Rudran97/pearl/pearl_files_git/Pearl/images/loading_screen.png

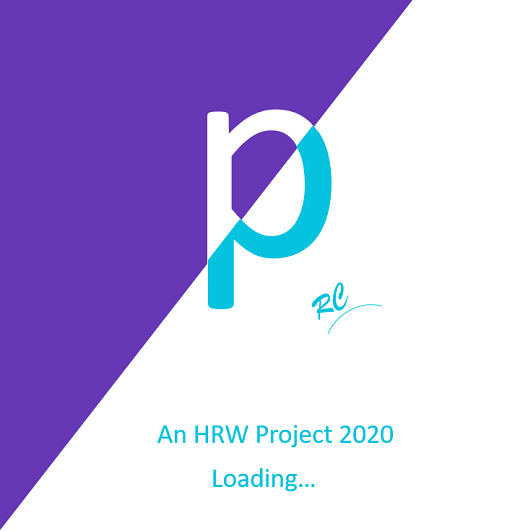
pearl_files_git/Pearl/images/loading_screen.png
