Rudran97/pearl/pearl_files_git/VHDL/rtl/control_fsm.vhd

----------------------------------------------------------------------------------
-- Company: 
-- Engineer: 
-- 
-- Create Date:    14:27:21 04/07/2020 
-- Design Name: 
-- Module Name:    CU2_e - CU2_a 
-- Project Name: 
-- Target Devices: 
-- Tool versions: 
-- Description: 
--
-- Dependencies: 
--
-- Revision: 
-- Revision 0.01 - File Created
-- Additional Comments: 
--
----------------------------------------------------------------------------------
library IEEE;
use IEEE.STD_LOGIC_1164.ALL;
use work.control_fsm_p.all;

-- Uncomment the following library declaration if using
-- arithmetic functions with Signed or Unsigned values
--use IEEE.NUMERIC_STD.ALL;

-- Uncomment the following library declaration if instantiating
-- any Xilinx primitives in this code.
--library UNISIM;
--use UNISIM.VComponents.all;

entity control_fsm is
	generic(
		gi_max_control_signal : integer := 74
	);
	port(pil_reset          : in  std_logic;
	     pil_clk            : in  std_logic;
	     pil_run_prog       : in  std_logic;
	     pil_halt_CU        : in  std_logic;
	     pov_CU_IR          : in  std_logic_vector(7 downto 0);
	     pil_CF_flag        : in  std_logic;
	     pil_ZF_flag        : in  std_logic;
	     pil_TF0_flag       : in  std_logic;
	     pil_TOV_flag       : in  std_logic;
	     pov_en_control_sig : out std_logic_vector(gi_max_control_signal downto 0)
	     );
end control_fsm;


architecture rtl of control_fsm is
	
	signal st_pr_step : CU_step_t := CU_fetch0a_st;

begin
	
	process (pil_reset, pil_clk)
	begin
		if (pil_reset = '1') then
			st_pr_step <= CU_fetch0a_st;
			pov_en_control_sig <= (others => '0');
		elsif (pil_clk'event and pil_clk = '0') then
			if (pil_run_prog = '1') then
				if (pil_halt_CU = '0') then
					case st_pr_step is
						when CU_fetch0a_st =>
							pov_en_control_sig (41 downto 0) <= c_fetch (0);
							pov_en_control_sig (ci_max_control_L downto 43) <= (others => '0');
							pov_en_control_sig (gi_max_control_signal downto 72) <= (others => '0');
							st_pr_step <= CU_fetch0b_st;
						
						when CU_fetch0b_st =>
							st_pr_step <= CU_fetch1a_st;
						
						when CU_fetch1a_st =>
							pov_en_control_sig (41 downto 0) <= c_fetch (1);
							pov_en_control_sig (ci_max_control_L downto 43) <= (others => '0');
							st_pr_step <= CU_fetch1b_st;
							
						when CU_fetch1b_st =>
							st_pr_step <= CU_fetch2_st;
							
						when CU_fetch2_st =>
							pov_en_control_sig (41 downto 0) <= c_fetch (2);
							pov_en_control_sig (ci_max_control_L downto 43) <= (others => '0');
							st_pr_step <= CU_0a_st;
							
						when CU_0a_st =>
							if (pov_CU_IR = cv_IC_NOP) then
								pov_en_control_sig (41 downto 0) <= (others => '0');
								pov_en_control_sig (ci_max_control_L downto 43) <= (others => '0');
								st_pr_step <= CU_0b_st;
							elsif (pov_CU_IR = cv_IC_LDA) then
								pov_en_control_sig (41 downto 0) <= c_LDA (0);
								pov_en_control_sig (ci_max_control_L downto 43) <= (others => '0');
								st_pr_step <= CU_0b_st;
							elsif (pov_CU_IR = cv_IC_ADD) then
								pov_en_control_sig (41 downto 0) <= c_ADD (0);
								pov_en_control_sig (ci_max_control_L downto 43) <= (others => '0');
								st_pr_step <= CU_0b_st;
							elsif (pov_CU_IR = cv_IC_SUB) then
								pov_en_control_sig (41 downto 0) <= c_SUB (0);
								pov_en_control_sig (ci_max_control_L downto 43) <= (others => '0');
								st_pr_step <= CU_0b_st;
							elsif (pov_CU_IR = cv_IC_STA) then
								pov_en_control_sig (41 downto 0) <= c_STA (0);
								pov_en_control_sig (ci_max_control_L downto 43) <= (others => '0');
								st_pr_step <= CU_0b_st;
							elsif (pov_CU_IR = cv_IC_LDI) then
								pov_en_control_sig (41 downto 0) <= c_LDI (0);
								pov_en_control_sig (ci_max_control_L downto 43) <= (others => '0');
								st_pr_step <= CU_0b_st;
							elsif (pov_CU_IR = cv_IC_JMP) then
								pov_en_control_sig (41 downto 0) <= c_JMP (0);
								pov_en_control_sig (ci_max_control_L downto 43) <= (others => '0');
								st_pr_step <= CU_0b_st;
							elsif (pov_CU_IR = cv_IC_JMC) then    --Instruction for JMP when Carry 
								if (pil_CF_flag = '1') then
									pov_en_control_sig (41 downto 0) <= c_JMP (0);			--JMP when carry set
									pov_en_control_sig (ci_max_control_L downto 43) <= (others => '0');
									st_pr_step <= CU_0b_st;
								else
									pov_en_control_sig (41 downto 0) <= c_JMP (1);			--No action when carry cleared
									pov_en_control_sig (ci_max_control_L downto 43) <= (others => '0');
									st_pr_step <= CU_0b_st;
								end if;
							elsif (pov_CU_IR = cv_IC_JMZ) then    --Instruction for JMP when Zero
								if (pil_ZF_flag = '1') then
									pov_en_control_sig (41 downto 0) <= c_JMP (0);			--JMP when Zero set
									pov_en_control_sig (ci_max_control_L downto 43) <= (others => '0');
									st_pr_step <= CU_0b_st;
								else
									pov_en_control_sig (41 downto 0) <= c_JMP (1);			--No action when Zero cleared
									pov_en_control_sig (ci_max_control_L downto 43) <= (others => '0');
									st_pr_step <= CU_0b_st;
								end if;
							elsif (pov_CU_IR = cv_IC_MOV_R0A) then
								pov_en_control_sig (41 downto 0) <= c_MOV_R0A (0);
								pov_en_control_sig (ci_max_control_L downto 43) <= (others => '0');
								st_pr_step <= CU_0b_st;
							elsif (pov_CU_IR = cv_IC_MOV_R0B) then
								pov_en_control_sig (41 downto 0) <= c_MOV_R0B (0);
								pov_en_control_sig (ci_max_control_L downto 43) <= (others => '0');
								st_pr_step <= CU_0b_st;
							elsif (pov_CU_IR = cv_IC_MOV_R0) then
								pov_en_control_sig (41 downto 0) <= c_MOV_R0 (0);
								pov_en_control_sig (ci_max_control_L downto 43) <= (others => '0');
								st_pr_step <= CU_0b_st;
							elsif (pov_CU_IR = cv_IC_MOV_A_R0A) then
								pov_en_control_sig (41 downto 0) <= c_MOV_A_R0A (0);
								pov_en_control_sig (ci_max_control_L downto 43) <= (others => '0');
								st_pr_step <= CU_0b_st;
							elsif (pov_CU_IR = cv_IC_MOV_A_R0B) then
								pov_en_control_sig (41 downto 0) <= c_MOV_A_R0B (0);
								pov_en_control_sig (ci_max_control_L downto 43) <= (others => '0');
								st_pr_step <= CU_0b_st;
							elsif (pov_CU_IR = cv_IC_OUT) then
								pov_en_control_sig (41 downto 0) <= c_OUT (0);
								pov_en_control_sig (ci_max_control_L downto 43) <= (others => '0');
								st_pr_step <= CU_0b_st;
							elsif (pov_CU_IR = cv_IC_HLT) then
								pov_en_control_sig (41 downto 0) <= c_HLT (0);
								pov_en_control_sig (ci_max_control_L downto 43) <= (others => '0');
								st_pr_step <= CU_0b_st;
							elsif (pov_CU_IR = cv_IC_MOV_A_R0) then
								pov_en_control_sig (41 downto 0) <= c_MOV_A_R0 (0);
								pov_en_control_sig (ci_max_control_L downto 43) <= (others => '0');
								st_pr_step <= CU_0b_st;
							elsif (pov_CU_IR = cv_IC_MOV_R0_A) then
								pov_en_control_sig (41 downto 0) <= c_MOV_R0_A (0);
								pov_en_control_sig (ci_max_control_L downto 43) <= (others => '0');
								st_pr_step <= CU_0b_st;
							elsif (pov_CU_IR = cv_IC_MOV_R1A) then
								pov_en_control_sig (41 downto 0) <= c_MOV_R1A (0);
								pov_en_control_sig (ci_max_control_L downto 43) <= (others => '0');
								st_pr_step <= CU_0b_st;
							elsif (pov_CU_IR = cv_IC_MOV_R1B) then
								pov_en_control_sig (41 downto 0) <= c_MOV_R1B (0);
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
								pov_en_control_sig (41 downto 0) <= c_MOV_P0_A (0);
								pov_en_control_sig (ci_max_control_L downto 43) <= (others => '0');
								st_pr_step <= CU_0b_st;
							elsif (pov_CU_IR = cv_IC_MOV_P0) then
								pov_en_control_sig (41 downto 0) <= c_MOV_P0 (0);
								pov_en_control_sig (ci_max_control_L downto 43) <= (others => '0');
								st_pr_step <= CU_0b_st;
							elsif (pov_CU_IR = cv_IC_JB_TF0) then		-- Instruction for JMP when TF0 bit is SET (JB TF0)
								if (pil_TF0_flag = '1') then
--									pov_en_control_sig (41 downto 0) <= c_J_TF0 (0);		-- JMP when TF0 bit is set
--									pov_en_control_sig (ci_max_control_L downto 43) <= (others => '0');
									pov_en_control_sig (41 downto 0) <= (others => '0');
									pov_en_control_sig (ci_max_control_L downto 43) <= (others => '0');
									pov_en_control_sig (6) <= '1';
									st_pr_step <= CU_0a_st;
								else
									pov_en_control_sig (41 downto 0) <= c_J_TF0 (1);		-- No action when cleared
									pov_en_control_sig (ci_max_control_L downto 43) <= (others => '0');
									st_pr_step <= CU_0b_st;
								end if;
								--st_pr_step <= CU_0b_st;
							elsif (pov_CU_IR = cv_IC_JNB_TF0) then		-- Instruction for JMP when TF0 bit is cleared (JNB TF0)
								if (pil_TF0_flag = '0') then
									--pov_en_control_sig (41 downto 0) <= c_J_TF0 (0);		-- JMP when TF0 bit is cleared
									--pov_en_control_sig (ci_max_control_L downto 43) <= (others => '0');
									pov_en_control_sig (41 downto 0) <= (others => '0');
									pov_en_control_sig (ci_max_control_L downto 43) <= (others => '0');
									pov_en_control_sig (6) <= '1';
									st_pr_step <= CU_0a_st;
								else
									pov_en_control_sig (41 downto 0) <= c_J_TF0 (1);      -- JMP when TF0 bit is set
									pov_en_control_sig (ci_max_control_L downto 43) <= (others => '0');
									st_pr_step <= CU_0b_st;
								end if;
								--st_pr_step <= CU_0b_st;
							elsif (pov_CU_IR = cv_IC_SET_T0E) then
								pov_en_control_sig (41 downto 0) <= c_S_C_T0E (0);
								pov_en_control_sig (ci_max_control_L downto 43) <= (others => '0');
								st_pr_step <= CU_0b_st;
							elsif (pov_CU_IR = cv_IC_CLR_T0) then
								pov_en_control_sig (41 downto 0) <= c_S_C_T0E (1);
								pov_en_control_sig (ci_max_control_L downto 43) <= (others => '0');
								pov_en_control_sig (42) <= '0';
								pov_en_control_sig (70) <= '0';
								pov_en_control_sig (71) <= '0';
								st_pr_step <= CU_0b_st;
							elsif (pov_CU_IR = cv_IC_SET_TR0) then
								pov_en_control_sig (41 downto 0) <= (others => '0');
								pov_en_control_sig (ci_max_control_L downto 43) <= (others => '0');
								pov_en_control_sig (42) <= '1';
								pov_en_control_sig (6) <= '1';
								st_pr_step <= CU_0b_st;
							elsif (pov_CU_IR = cv_IC_MOV_TH0) then
								pov_en_control_sig (41 downto 0) <= c_MOV_TH0 (0);
								pov_en_control_sig (ci_max_control_L downto 43) <= (others => '0');
								st_pr_step <= CU_0b_st;
							elsif (pov_CU_IR = cv_IC_MOV_TL0) then
								pov_en_control_sig (41 downto 0) <= c_MOV_TL0 (0);
								pov_en_control_sig (ci_max_control_L downto 43) <= (others => '0');
								st_pr_step <= CU_0b_st;
							elsif (pov_CU_IR = cv_IC_MOV_CS0) then
								pov_en_control_sig (41 downto 0) <= c_MOV_CS0 (0);
								pov_en_control_sig (ci_max_control_L downto 43) <= (others => '0');
								st_pr_step <= CU_0b_st;
							elsif (pov_CU_IR = cv_IC_INC_R0A) then
								pov_en_control_sig (41 downto 0) <= c_INC_R0A (0);
								pov_en_control_sig (ci_max_control_L downto 43) <= (others => '0');
								st_pr_step <= CU_0b_st;
							elsif (pov_CU_IR = cv_IC_INC_R0B) then
								pov_en_control_sig (41 downto 0) <= c_INC_R0B (0);
								pov_en_control_sig (ci_max_control_L downto 43) <= (others => '0');
								st_pr_step <= CU_0b_st;
							elsif (pov_CU_IR = cv_IC_INC_R0) then
								pov_en_control_sig (41 downto 0) <= c_INC_R0 (0);
								pov_en_control_sig (ci_max_control_L downto 43) <= (others => '0');
								st_pr_step <= CU_0b_st;
							elsif (pov_CU_IR = cv_IC_INC_R1A) then
								pov_en_control_sig (41 downto 0) <= c_INC_R1A (0);
								pov_en_control_sig (ci_max_control_L downto 43) <= (others => '0');
								st_pr_step <= CU_0b_st;
							elsif (pov_CU_IR = cv_IC_INC_R1B) then
								pov_en_control_sig (41 downto 0) <= c_INC_R1B (0);
								pov_en_control_sig (ci_max_control_L downto 43) <= (others => '0');
								st_pr_step <= CU_0b_st;
							elsif (pov_CU_IR = cv_IC_INC_R1) then
								pov_en_control_sig (41 downto 0) <= c_INC_R1 (0);
								pov_en_control_sig (ci_max_control_L downto 43) <= (others => '0');
								st_pr_step <= CU_0b_st;
							elsif (pov_CU_IR = cv_IC_INC_R2A) then
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
								pov_en_control_sig (41 downto 0) <= c_MOV_A_TC0L (0);
								pov_en_control_sig (ci_max_control_L downto 43) <= (others => '0');
								pov_en_control_sig (68) <= '1';
								st_pr_step <= CU_0b_st;
							elsif (pov_CU_IR = cv_IC_MOV_A_TC0H) then
								pov_en_control_sig (41 downto 0) <= c_MOV_A_TC0H (0);
								pov_en_control_sig (ci_max_control_L downto 43) <= (others => '0');
								pov_en_control_sig (69) <= '1';
								st_pr_step <= CU_0b_st;
							elsif (pov_CU_IR = cv_IC_SET_TCR0E) then
								pov_en_control_sig (41 downto 0) <= c_SET_TCR0E (0);
								pov_en_control_sig (ci_max_control_L downto 43) <= (others => '0');
								pov_en_control_sig (70) <= '1';
								pov_en_control_sig (71) <= '1';
								st_pr_step <= CU_0b_st;
							elsif (pov_CU_IR = cv_IC_JB_T0V) then
								if (pil_TOV_flag = '1') then
									pov_en_control_sig (41 downto 0) <= c_JB_NB_T0V (0);
									pov_en_control_sig (ci_max_control_L downto 43) <= (others => '0');
									pov_en_control_sig (71) <= '1';
								else
									pov_en_control_sig (41 downto 0) <= c_JB_NB_T0V (1);
									pov_en_control_sig (ci_max_control_L downto 43) <= (others => '0');
									pov_en_control_sig (71) <= '1';
								end if;
								st_pr_step <= CU_0b_st;
							elsif (pov_CU_IR = cv_IC_JNB_T0V) then
								if (pil_TOV_flag = '0') then
									pov_en_control_sig (41 downto 0) <= c_JB_NB_T0V (0);
									pov_en_control_sig (ci_max_control_L downto 43) <= (others => '0');
									pov_en_control_sig (71) <= '1';
								else
									pov_en_control_sig (41 downto 0) <= c_JB_NB_T0V (1);
									pov_en_control_sig (ci_max_control_L downto 43) <= (others => '0');
									pov_en_control_sig (71) <= '1';
								end if;
								st_pr_step <= CU_0b_st;
							elsif (pov_CU_IR = cv_IC_SET_TC0L) then
								pov_en_control_sig (41 downto 0) <= (others => '0');
								pov_en_control_sig (ci_max_control_L downto 43) <= (others => '0');
								pov_en_control_sig (72) <= '1';
								st_pr_step <= CU_0b_st;
							elsif (pov_CU_IR = cv_IC_MOV_PC_A) then
								pov_en_control_sig (41 downto 0) <= c_MOV_PC_A (0);
								pov_en_control_sig (ci_max_control_L downto 43) <= (others => '0');
								st_pr_step <= CU_0b_st;
							elsif (pov_CU_IR = cv_IC_MOV_A_PC) then
								pov_en_control_sig (41 downto 0) <= c_MOV_A_PC (0);
								pov_en_control_sig (ci_max_control_L downto 43) <= (others => '0');
								st_pr_step <= CU_0b_st;
							elsif (pov_CU_IR = cv_IC_MOV_LR) then
								pov_en_control_sig (41 downto 0) <= c_MOV_LR (0);
								pov_en_control_sig (ci_max_control_L downto 43) <= (others => '0');
								pov_en_control_sig (74) <= '1';
								st_pr_step <= CU_0b_st;
							elsif (pov_CU_IR = cv_IC_MOV_LR_A) then
								pov_en_control_sig (41 downto 0) <= c_MOV_LR_A (0);
								pov_en_control_sig (ci_max_control_L downto 43) <= (others => '0');
								pov_en_control_sig (74) <= '1';
								st_pr_step <= CU_0b_st;
							elsif (pov_CU_IR = cv_IC_MOV_A_LR) then
								pov_en_control_sig (41 downto 0) <= c_MOV_A_LR (0);
								pov_en_control_sig (ci_max_control_L downto 43) <= (others => '0');
								pov_en_control_sig (73) <= '1';
								st_pr_step <= CU_0b_st;
							elsif (pov_CU_IR = cv_IC_MOV_PC_LR) then
								pov_en_control_sig (41 downto 0) <= c_MOV_PC_LR (0);
								pov_en_control_sig (ci_max_control_L downto 43) <= (others => '0');
								pov_en_control_sig (73) <= '1';
								st_pr_step <= CU_0b_st;
							elsif (pov_CU_IR = cv_IC_MOV_LR_PC) then
								pov_en_control_sig (41 downto 0) <= c_MOV_LR_PC (0);
								pov_en_control_sig (ci_max_control_L downto 43) <= (others => '0');
								pov_en_control_sig (74) <= '1';
								st_pr_step <= CU_0b_st;
							elsif (pov_CU_IR = cv_IC_SUBB_R0) then
								pov_en_control_sig (41 downto 0) <= c_SUBB_R0 (0);
								pov_en_control_sig (ci_max_control_L downto 43) <= (others => '0');
								st_pr_step <= CU_0b_st;	
							elsif (pov_CU_IR = cv_IC_SUBB_R1) then
								pov_en_control_sig (41 downto 0) <= c_SUBB_R1 (0);
								pov_en_control_sig (ci_max_control_L downto 43) <= (others => '0');
								st_pr_step <= CU_0b_st;
							elsif (pov_CU_IR = cv_IC_SUBB_R2) then
								pov_en_control_sig (41 downto 0) <= c_SUBB_R2 (0);
								pov_en_control_sig (ci_max_control_L downto 43) <= (others => '0');
								st_pr_step <= CU_0b_st;
							elsif (pov_CU_IR = cv_IC_SUBB_R3) then
								pov_en_control_sig (41 downto 0) <= c_SUBB_R3 (0);
								pov_en_control_sig (ci_max_control_L downto 43) <= (others => '0');
								pov_en_control_sig (56) <= '1';
								st_pr_step <= CU_0b_st;
							elsif (pov_CU_IR = cv_IC_SUBIB) then
								pov_en_control_sig (41 downto 0) <= c_SUBIB (0);
								pov_en_control_sig (ci_max_control_L downto 43) <= (others => '0');
								st_pr_step <= CU_0b_st;
							elsif (pov_CU_IR = cv_IC_SUBB) then
								pov_en_control_sig (41 downto 0) <= c_SUBB (0);
								pov_en_control_sig (ci_max_control_L downto 43) <= (others => '0');
								st_pr_step <= CU_0b_st;
							end if;
							
							
						when CU_0b_st =>
							if (pov_CU_IR = cv_IC_NOP) then
								st_pr_step <= CU_1a_st;
							elsif (pov_CU_IR = cv_IC_LDA) then
								st_pr_step <= CU_1a_st;
							elsif (pov_CU_IR = cv_IC_ADD) then
								st_pr_step <= CU_1a_st;
							elsif (pov_CU_IR = cv_IC_SUB) then
								st_pr_step <= CU_1a_st;
							elsif (pov_CU_IR = cv_IC_STA) then
								st_pr_step <= CU_1a_st;
							elsif (pov_CU_IR = cv_IC_LDI) then
								st_pr_step <= CU_fetch0a_st;
							elsif (pov_CU_IR = cv_IC_JMP) then
								st_pr_step <= CU_fetch0a_st;
							elsif (pov_CU_IR = cv_IC_JMC) then    --Instruction for JMP when Carry 
								st_pr_step <= CU_fetch0a_st;
							elsif (pov_CU_IR = cv_IC_JMZ) then    --Instruction for JMP when Zero
								st_pr_step <= CU_fetch0a_st;
							elsif (pov_CU_IR = cv_IC_MOV_R0A) then
								st_pr_step <= CU_fetch0a_st;
							elsif (pov_CU_IR = cv_IC_MOV_R0B) then
								st_pr_step <= CU_fetch0a_st;
							elsif (pov_CU_IR = cv_IC_MOV_R0) then
								st_pr_step <= CU_fetch0a_st;
							elsif (pov_CU_IR = cv_IC_MOV_A_R0A) then
								st_pr_step <= CU_fetch0a_st;
							elsif (pov_CU_IR = cv_IC_MOV_A_R0B) then
								st_pr_step <= CU_fetch0a_st;
							elsif (pov_CU_IR = cv_IC_OUT) then
								st_pr_step <= CU_fetch0a_st;
							elsif (pov_CU_IR = cv_IC_HLT) then
								st_pr_step <= CU_fetch0a_st;
							elsif (pov_CU_IR = cv_IC_MOV_A_R0) then
								st_pr_step <= CU_fetch0a_st;
							elsif (pov_CU_IR = cv_IC_MOV_R0_A) then
								st_pr_step <= CU_fetch0a_st;
							elsif (pov_CU_IR = cv_IC_MOV_R1A) then
								st_pr_step <= CU_fetch0a_st;
							elsif (pov_CU_IR = cv_IC_MOV_R1B) then
								st_pr_step <= CU_fetch0a_st;
							elsif (pov_CU_IR = cv_IC_MOV_R1) then
								st_pr_step <= CU_fetch0a_st;
							elsif (pov_CU_IR = cv_IC_MOV_A_R1A) then
								st_pr_step <= CU_fetch0a_st;
							elsif (pov_CU_IR = cv_IC_MOV_A_R1B) then
								st_pr_step <= CU_fetch0a_st;
							elsif (pov_CU_IR = cv_IC_MOV_A_R1) then
								st_pr_step <= CU_fetch0a_st;
							elsif (pov_CU_IR = cv_IC_MOV_R1_A) then
								st_pr_step <= CU_fetch0a_st;
							elsif (pov_CU_IR = cv_IC_MOV_R2A) then
								st_pr_step <= CU_fetch0a_st;
							elsif (pov_CU_IR = cv_IC_MOV_R2B) then
								st_pr_step <= CU_fetch0a_st;
							elsif (pov_CU_IR = cv_IC_MOV_R2) then
								st_pr_step <= CU_fetch0a_st;
							elsif (pov_CU_IR = cv_IC_MOV_A_R2A) then
								st_pr_step <= CU_fetch0a_st;
							elsif (pov_CU_IR = cv_IC_MOV_A_R2B) then
								st_pr_step <= CU_fetch0a_st;
							elsif (pov_CU_IR = cv_IC_MOV_A_R2) then
								st_pr_step <= CU_fetch0a_st;
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
								st_pr_step <= CU_fetch0a_st;
							elsif (pov_CU_IR = cv_IC_AND_R0) then
								st_pr_step <= CU_1a_st;
							elsif (pov_CU_IR = cv_IC_AND_R1) then
								st_pr_step <= CU_1a_st;
							elsif (pov_CU_IR = cv_IC_AND_R2) then
								st_pr_step <= CU_1a_st;
							elsif (pov_CU_IR = cv_IC_AND_R3) then
								st_pr_step <= CU_1a_st;
							elsif (pov_CU_IR = cv_IC_OR_R0) then
								st_pr_step <= CU_1a_st;
							elsif (pov_CU_IR = cv_IC_OR_R1) then
								st_pr_step <= CU_1a_st;
							elsif (pov_CU_IR = cv_IC_OR_R2) then
								st_pr_step <= CU_1a_st;
							elsif (pov_CU_IR = cv_IC_OR_R3) then
								st_pr_step <= CU_1a_st;
							elsif (pov_CU_IR = cv_IC_CPL_A) then
								st_pr_step <= CU_1a_st;
							elsif (pov_CU_IR = cv_IC_MOV_A_atR0) then
								st_pr_step <= CU_1a_st;
							elsif (pov_CU_IR = cv_IC_MOV_A_atR1) then
								st_pr_step <= CU_1a_st;
							elsif (pov_CU_IR = cv_IC_MOV_A_atR2) then
								st_pr_step <= CU_1a_st;
							elsif (pov_CU_IR = cv_IC_MOV_A_atR3) then
								st_pr_step <= CU_1a_st;
							elsif (pov_CU_IR = cv_IC_MOV_atR0_A) then
								st_pr_step <= CU_1a_st;
							elsif (pov_CU_IR = cv_IC_MOV_atR1_A) then
								st_pr_step <= CU_1a_st;
							elsif (pov_CU_IR = cv_IC_MOV_atR2_A) then
								st_pr_step <= CU_1a_st;
							elsif (pov_CU_IR = cv_IC_MOV_atR3_A) then
								st_pr_step <= CU_1a_st;
							elsif (pov_CU_IR = cv_IC_INC_R3) then
								st_pr_step <= CU_1a_st;
							elsif (pov_CU_IR = cv_IC_DEC_R3) then
								st_pr_step <= CU_1a_st;
							elsif (pov_CU_IR = cv_IC_DJNZ_R3) then
								st_pr_step <= CU_1a_st;
							elsif (pov_CU_IR = cv_IC_ADD_R3) then
								st_pr_step <= CU_1a_st;
							elsif (pov_CU_IR = cv_IC_SUB_R3) then
								st_pr_step <= CU_1a_st;
							elsif (pov_CU_IR = cv_IC_MOV_P0X_C) then
								st_pr_step <= CU_1a_st;
							elsif (pov_CU_IR = cv_IC_MOV_C_P0X) then
								st_pr_step <= CU_1a_st;
							elsif (pov_CU_IR = cv_IC_RDA_P0) then
								st_pr_step <= CU_1a_st;
							elsif (pov_CU_IR = cv_IC_MOV_A_C) then 				-- MOV A C
								st_pr_step <= CU_fetch0a_st;
							elsif (pov_CU_IR = cv_IC_MOV_C_A) then				-- MOV C A
								st_pr_step <= CU_fetch0a_st;
							elsif (pov_CU_IR = cv_IC_MOV_C) then				-- MOV C ...
								st_pr_step <= CU_fetch0a_st;
							elsif (pov_CU_IR = cv_IC_RRC) then				-- RRC
								pov_en_control_sig (41 downto 0) <= (others => '0');
								pov_en_control_sig (ci_max_control_L downto 43) <= (others => '0');
								st_pr_step <= CU_fetch0a_st;
							elsif (pov_CU_IR = cv_IC_RLC) then				-- RLC
								pov_en_control_sig (41 downto 0) <= (others => '0');
								pov_en_control_sig (ci_max_control_L downto 43) <= (others => '0');
								st_pr_step <= CU_fetch0a_st;
							elsif (pov_CU_IR = cv_IC_PUSH_A) then				-- PUSH A
								st_pr_step <= CU_fetch0a_st;
							elsif (pov_CU_IR = cv_IC_POP_A) then				-- POP A
								st_pr_step <= CU_fetch0a_st;
							elsif (pov_CU_IR = cv_IC_ADDI) then
								st_pr_step <= CU_1a_st;
							elsif (pov_CU_IR = cv_IC_SUBI) then
								st_pr_step <= CU_1a_st;
							elsif (pov_CU_IR = cv_IC_DDRP1) then
								st_pr_step <= CU_fetch0a_st;
							elsif (pov_CU_IR = cv_IC_MOV_P1) then
								st_pr_step <= CU_fetch0a_st;
							elsif (pov_CU_IR = cv_IC_MOV_P1_A) then
								st_pr_step <= CU_fetch0a_st;
							elsif (pov_CU_IR = cv_IC_MOV_A_P1) then
								st_pr_step <= CU_fetch0a_st;
							elsif (pov_CU_IR = cv_IC_SET_P1X) then
								st_pr_step <= CU_1a_st;
							elsif (pov_CU_IR = cv_IC_CLR_P1X) then
								st_pr_step <= CU_1a_st;
							elsif (pov_CU_IR = cv_IC_MOV_P1X_C) then
								st_pr_step <= CU_1a_st;
							elsif (pov_CU_IR = cv_IC_MOV_C_P1X) then
								st_pr_step <= CU_1a_st;
							elsif (pov_CU_IR = cv_IC_RDA_P1) then
								st_pr_step <= CU_1a_st;
							elsif (pov_CU_IR = cv_IC_CMPI) then
								st_pr_step <= CU_1a_st;
							elsif (pov_CU_IR = cv_IC_CMP) then
								st_pr_step <= CU_1a_st;
							elsif (pov_CU_IR = cv_IC_MOV_A_TH0) then
								st_pr_step <= CU_fetch0a_st;
							elsif (pov_CU_IR = cv_IC_MOV_A_TL0) then
								st_pr_step <= CU_fetch0a_st;
							elsif (pov_CU_IR = cv_IC_MOV_CS0_A) then
								st_pr_step <= CU_fetch0a_st;
							elsif (pov_CU_IR = cv_IC_ADDC_R0) then
								st_pr_step <= CU_1a_st;
							elsif (pov_CU_IR = cv_IC_ADDC_R1) then
								st_pr_step <= CU_1a_st;
							elsif (pov_CU_IR = cv_IC_ADDC_R2) then
								st_pr_step <= CU_1a_st;
							elsif (pov_CU_IR = cv_IC_ADDC_R3) then
								st_pr_step <= CU_1a_st;
							elsif (pov_CU_IR = cv_IC_ADDIC) then
								st_pr_step <= CU_1a_st;
							elsif (pov_CU_IR = cv_IC_ADDC) then
								st_pr_step <= CU_1a_st;
							elsif (pov_CU_IR = cv_IC_MOV_A_TC0L) then
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
							elsif (pov_CU_IR = cv_IC_ADDC_R2) then
								st_pr_step <= CU_fetch0a_st;
							elsif (pov_CU_IR = cv_IC_ADDC_R3) then
								st_pr_step <= CU_fetch0a_st;
							elsif (pov_CU_IR = cv_IC_ADDIC) then
								st_pr_step <= CU_fetch0a_st;
							elsif (pov_CU_IR = cv_IC_ADDC) then
								st_pr_step <= CU_2a_st;
							elsif (pov_CU_IR = cv_IC_SUBB_R0) then
								st_pr_step <= CU_2a_st;	
							elsif (pov_CU_IR = cv_IC_SUBB_R1) then
								st_pr_step <= CU_2a_st;
							elsif (pov_CU_IR = cv_IC_SUBB_R2) then
								st_pr_step <= CU_2a_st;
							elsif (pov_CU_IR = cv_IC_SUBB_R3) then
								st_pr_step <= CU_2a_st;
							elsif (pov_CU_IR = cv_IC_SUBIB) then
								st_pr_step <= CU_2a_st;
							elsif (pov_CU_IR = cv_IC_SUBB) then
								st_pr_step <= CU_2a_st;
							end if;
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
