Rudran97/pearl/pearl_files_git/VHDL/rtl/control_fsm_p.vhd

library IEEE;
use IEEE.STD_LOGIC_1164.all;

package control_fsm_p is

	type CU_step_t is (
		CU_fetch0a_st,
		CU_fetch0b_st,
		CU_fetch1a_st,
		CU_fetch1b_st,
		CU_fetch2_st,
		CU_0a_st,
		CU_0b_st,
		CU_1a_st,
		CU_1b_st,
		CU_2a_st,
		CU_2b_st,
		CU_3a_st,
		CU_3b_st,
		CU_4a_st,
		CU_4b_st,
		CU_5a_st,
		CU_5b_st,
		CU_6a_st,
		CU_6b_st,
		CU_7a_st,
		CU_7b_st,
		CU_8a_st,
		CU_8b_st,
		CU_9a_st,
		CU_9b_st,
		CU_10a_st,
		CU_10b_st,
		CU_11a_st,
		CU_11b_st,
		CU_12a_st,
		CU_12b_st,
		CU_13a_st,
		CU_13b_st,
		CU_idle1_st,
		CU_idle2_st
	);

	type tv_micro_codes is array (0 to 13) of std_logic_vector(41 downto 0);
	--Instruction Allocation--
	constant c_fetch      : tv_micro_codes := ("000000000000000000000100000000000100000000", "000000000000000000000001010000000000000000", "000000000000000000000000000000001000000000", "000000000000000000000000000000000000000000", "000000000000000000000000000000000000000000", "000000000000000000000000000000000000000000", "000000000000000000000000000000000000000000", "000000000000000000000000000000000000000000", "000000000000000000000000000000000000000000", "000000000000000000000000000000000000000000", "000000000000000000000000000000000000000000", "000000000000000000000000000000000000000000", "000000000000000000000000000000000000000000", "000000000000000000000000000000000000000000"); -- (0) MI CO   (1) RO II       (2) CE
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
	constant c_SUBB       : tv_micro_codes := ("000000000000000000000100100000000000000000", "000000000000000000000001000000100000000000", "000000000000000000000000001011000001000000", "000000000000000000000000000000100000000000", "000000000000000000000000001010000001000000", "000000000000000000000000001011000001000000", "000000000000000000000000000000000000000000", "000000000000000000000000000000000000000000", "000000000000000000000000000000000000000000", "000000000000000000000000000000000000000000", "000000000000000000000000000000000000000000", "000000000000000000000000000000000000000000", "000000000000000000000000000000000000000000", "000000000000000000000000000000000000000000");
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
